Marcolist/EspMoveLamp/hardware/stl/esp32_pcb_carrier.stl

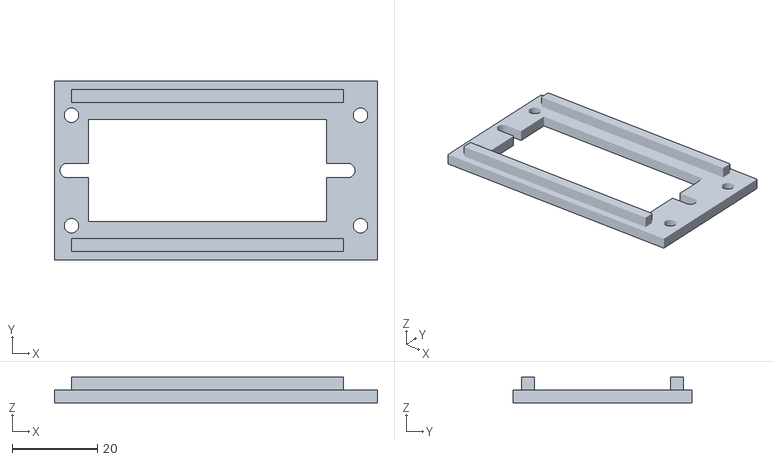
[picture p5: CAD file, 2026-10-15]
hardware/stl/esp32_pcb_carrier.stl
76.0 x 42.0 x 6.00
