Marcolist/EspMoveLamp/hardware/stl/left_electronics_cover.stl

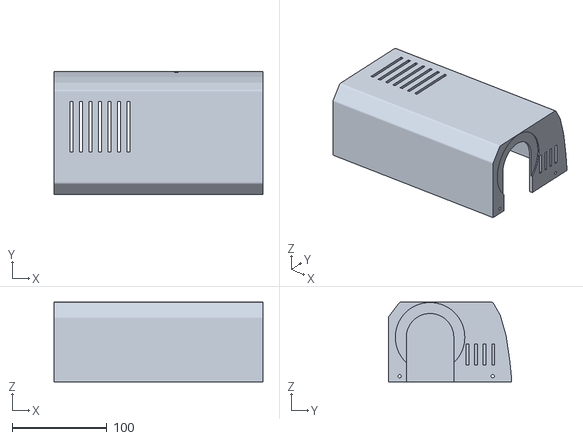
[picture p6: CAD file, 2026-10-15]
hardware/stl/left_electronics_cover.stl
220.0 x 130.0 x 84.0
