Marcolist/EspMoveLamp/hardware/stl/right_cover.stl

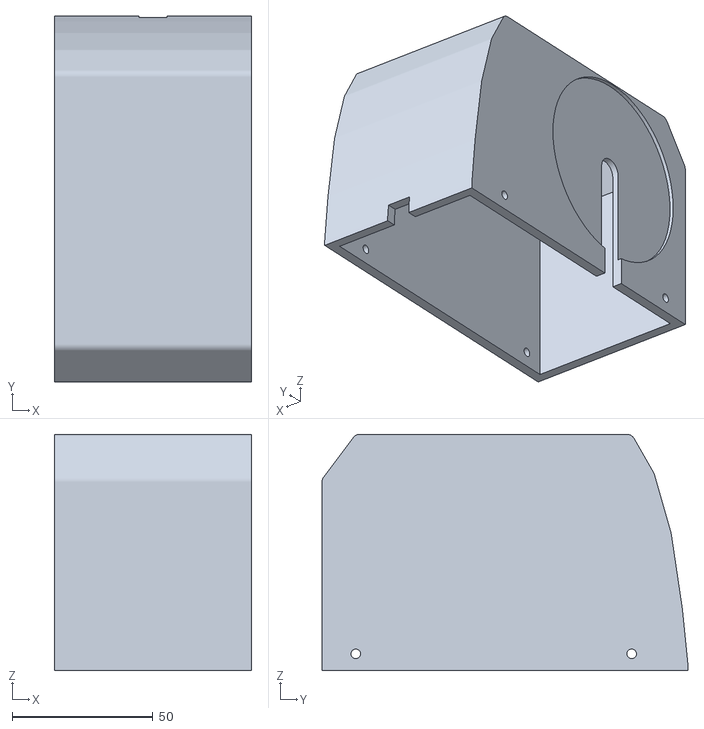
[picture p7: CAD file, 2026-10-15]
hardware/stl/right_cover.stl
70.0 x 130.0 x 84.0
