Marcolist/EspMoveLamp/hardware/stl/psu_terminal_cover.stl

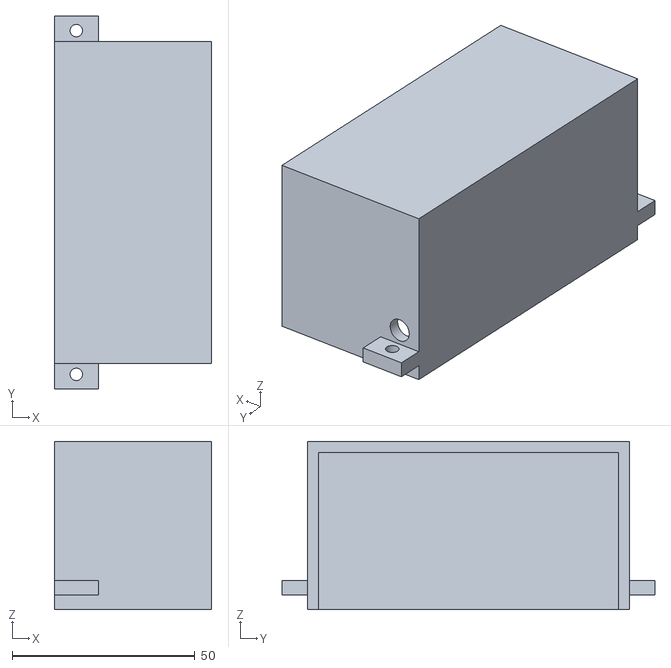
[picture p8: CAD file, 2026-10-15]
hardware/stl/psu_terminal_cover.stl
43.0 x 102.0 x 46.0
