Marcolist/EspMoveLamp/hardware/stl/left_electronics_base.stl

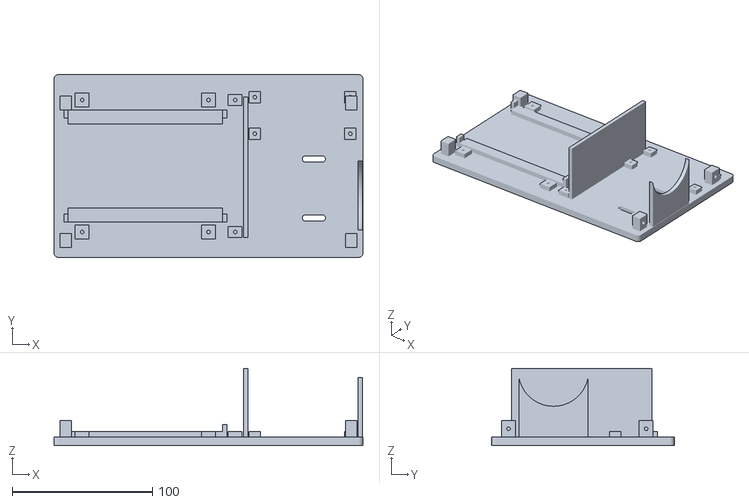
[picture p9: CAD file, 2026-10-15]
hardware/stl/left_electronics_base.stl
220.0 x 130.0 x 55.0
