Marcolist/EspMoveLamp/hardware/stl/right_axle_base.stl

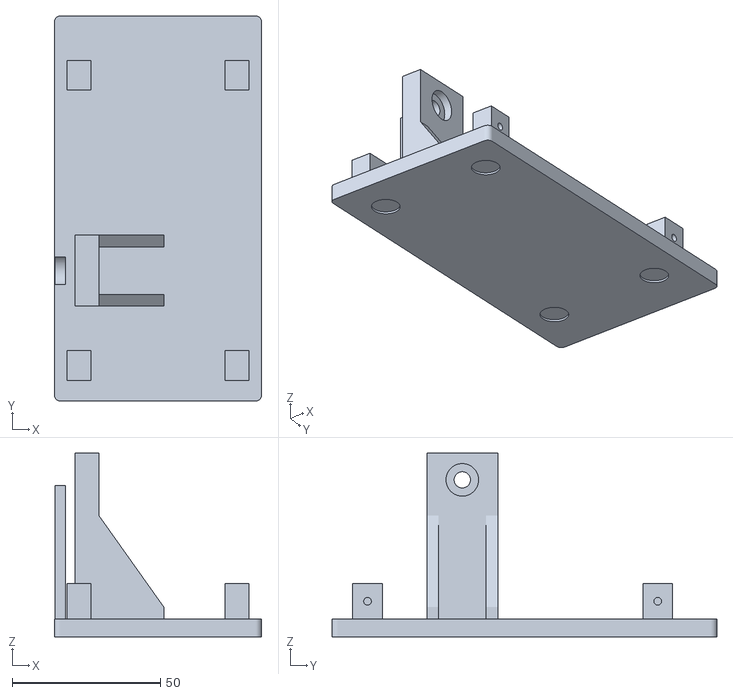
[picture p10: CAD file, 2026-10-15]
hardware/stl/right_axle_base.stl
70.0 x 130.0 x 62.0
