Marcolist/EspMoveLamp/hardware/stl/psu_retaining_bracket_2x.stl

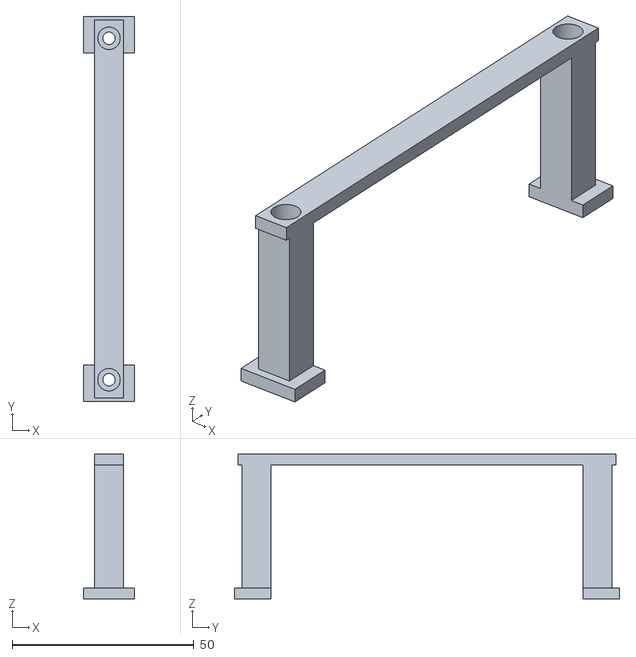
[picture p11: CAD file, 2026-10-15]
hardware/stl/psu_retaining_bracket_2x.stl
14.0 x 106.0 x 39.8
