Marcolist/EspMoveLamp/hardware/stl/profile_front_coupling_disc_2x.stl

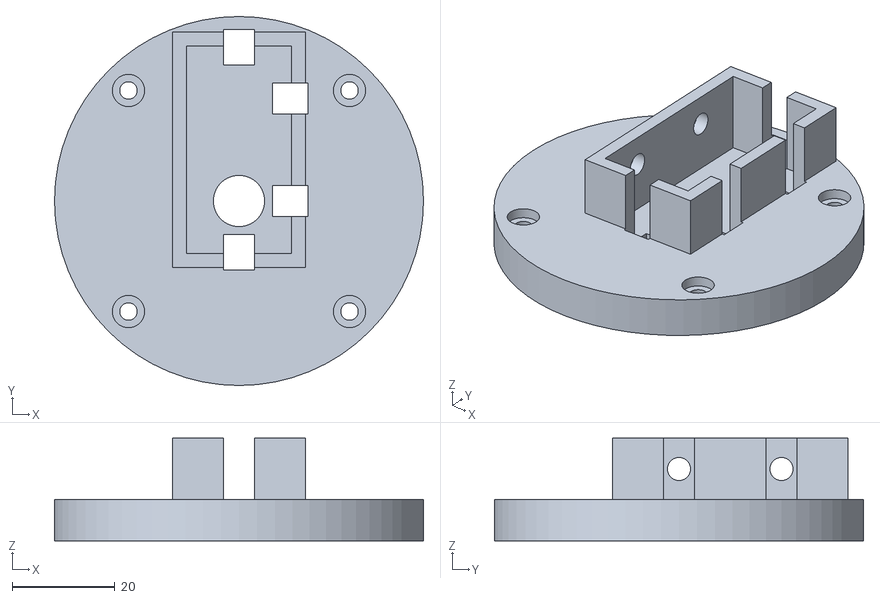
[picture p12: CAD file, 2026-10-15]
hardware/stl/profile_front_coupling_disc_2x.stl
72.0 x 72.0 x 20.0
