Marcolist/EspMoveLamp/hardware/stl/esp32_pcb_retainer_2x.stl

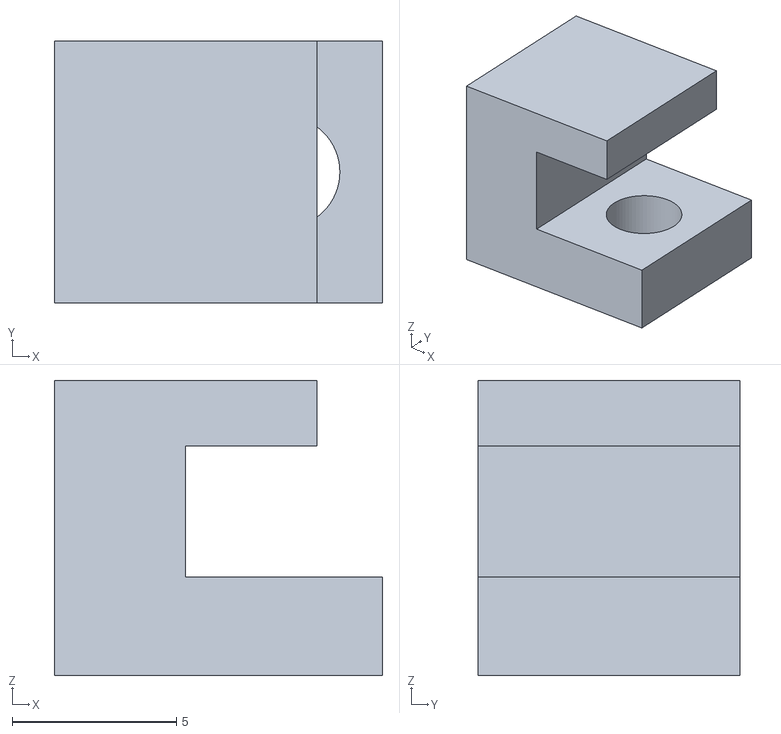
[picture p13: CAD file, 2026-10-15]
hardware/stl/esp32_pcb_retainer_2x.stl
10.0 x 8.00 x 9.00
