Marcolist/EspMoveLamp/hardware/stl/axle_rear_coupling_disc.stl

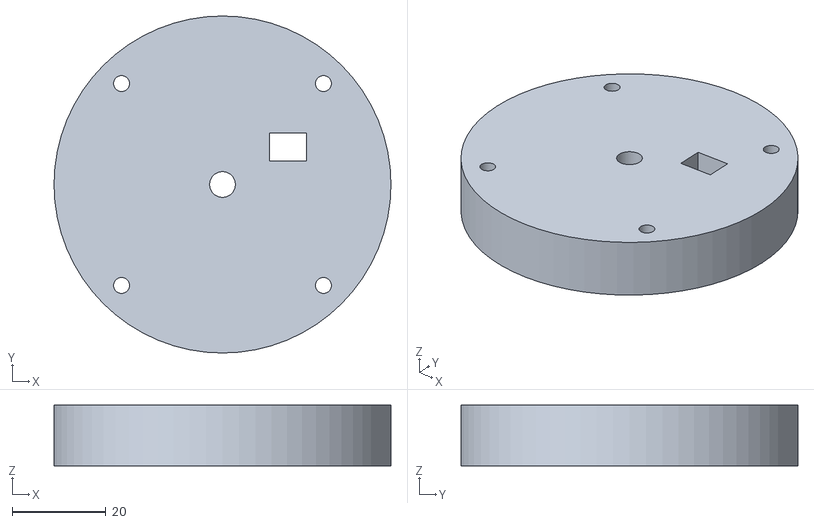
[picture p14: CAD file, 2026-10-15]
hardware/stl/axle_rear_coupling_disc.stl
72.0 x 72.0 x 13.0
