Marcolist/EspMoveLamp/hardware/stl/left_ds3225_servo_mount.stl

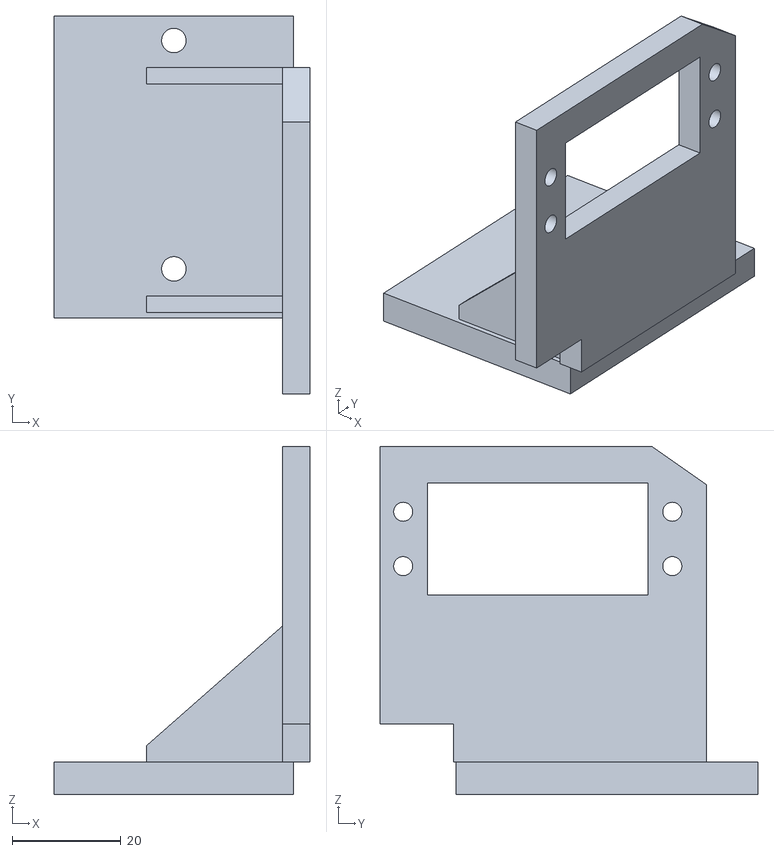
[picture p15: CAD file, 2026-10-15]
hardware/stl/left_ds3225_servo_mount.stl
47.0 x 69.5 x 64.0
