Marcolist/EspMoveLamp/hardware/cad/EspMoveLamp.scad

// EspMoveLamp mechanical prototype v0.9 / DS3225 / mm
part="left_base";
$fn=64;
W=70; D=130; H=90; wall=4; // Shared side profile; only widths differ.
axis_y=44; axis_z=53;
// DS3225 datasheet: body40x20, flange49.5x10, flange length54.5.
servo_body_l=40.6; servo_body_w=20.6;
servo_plate_x=10; // adjustable bracket via base slots
servo_plate_thick=5;
// Horn outer screw radius24 documented; outline clearances remain fit test.
horn_r=24; horn_total=35.8; horn_width=15.8; horn_thickness=6.3;
profile_w=20.5; profile_h=40.5;
cap_d=72; cap_bolt_r=30.5;
cable_slot_width=6; // provisional until actual extrusion slot measured
// Common concealed outlet, away from negative-u servo arm.
module wireport(h=40){translate([10,5,-1])cube([8,6,h]);}
module nutports(){
 // Actual four LED faces: two at +u, one at +v, one at -v.
 for(v=[0,20])translate([6.5,v-cable_slot_width/2,-1])cube([7,cable_slot_width,25]);
 for(v=[-10,30])translate([-cable_slot_width/2,v-3.5,-1])cube([cable_slot_width,7,25]);
}
module wirepath(points){for(i=[0:len(points)-2])hull(){
 for(j=[i,i+1])translate([points[j][0],points[j][1],-0.1])cylinder(d=cable_slot_width,h=3.1);
}}
module wirechannels(){
 wirepath([[10,0],[14,8]]);
 wirepath([[10,20],[14,8]]);
 wirepath([[0,30],[14,24],[14,8]]);
 wirepath([[0,-10],[14,-10],[14,8]]);
}
module profile(){
 // Same full-size side contour for both stands; no scaling of axle features.
 offset(r=3)offset(delta=-3)
 polygon([[0,0],[D,0],[D,8],[D-2,28],[D-6,55],
          [D-12,76],[D-20,H],[12,H],[0,74]]);
}

module extrude_x(l){rotate([90,0,90])linear_extrude(l)children();}
module xhole(x,y,z,d,l){translate([x,y,z])rotate([0,90,0])cylinder(d=d,h=l);}
module zhole(x,y,z,d,l){translate([x,y,z])cylinder(d=d,h=l);}
module zslot(x1,x2,y,z,d,h){hull(){zhole(x1,y,z,d,h);zhole(x2,y,z,d,h);}}
module base(right=true){difference(){union(){
 linear_extrude(6)offset(r=2)offset(delta=-2)square([W,D]);
 // Hood attachment lugs, accessible horizontally from outside.
 for(x=[8.3,61.7],y=[12,110])translate([x-4,y-5,6])cube([8,10,12]);
 if(!right){
 // Simple integral axle pedestal, completely exposed without hood.
 translate([7,32,6])cube([8,24,56]);
 for(y=[32,52])hull(){translate([7,y,6])cube([30,4,4]);translate([7,y,6])cube([8,4,35]);}
 }
 }
 for(y=[12,110]){xhole(-1,y,12,2.6,13);xhole(58,y,12,2.6,13);}
 if(right){
 // M4 through slots allow the bracket to move 12mm along servo axis.
 for(y=[28,70])zslot(29,41,y,-1,4.5,8);
 }else{xhole(6,axis_y,axis_z,5.5,11);xhole(12,axis_y,axis_z,11,5);}
 // Anti-slip pad pockets on underside.
 for(x=[13,57],y=[15,110])zhole(x,y,-0.1,10,0.9);
}}
module servo_bracket(){difference(){union(){
 // Part in assembly coordinates, foot underside z6.
 translate([13,19,6])cube([44,55.5,6]);
 translate([servo_plate_x,0,0])extrude_x(servo_plate_thick)
 polygon([[5,12],[65,12],[65,63],[55,70],[5,70]]);
 // Buttress ribs stay below servo body and mounting ears.
 for(y=[20,62])hull(){translate([servo_plate_x,y,12])cube([30,3,3]);translate([servo_plate_x,y,12])cube([5,3,25]);}
 }
 // Clearance above forward hood attachment lug.
 translate([-1,0,5])cube([72,18.5,14]);
 translate([servo_plate_x-1,34-servo_body_l/2,53-servo_body_w/2])cube([7,servo_body_l,servo_body_w]);
 for(y=[34-49.5/2,34+49.5/2],z=[48,58])xhole(servo_plate_x-1,y,z,3.5,8);
 for(y=[28,70])zhole(35,y,5,4.5,9);
}}
module hood(right=true){difference(){
 extrude_x(70)profile();
 // Hollow right through lower edge, no hidden bottom membrane.
 translate([4,0,0])extrude_x(62)offset(delta=-4)profile();
 translate([-1,-1,-1])cube([W+2,D+2,7]);
 // U opening permits lifting hood off the installed spindle.
 hull(){xhole(-1,axis_y,axis_z,right?50:10,7);xhole(-1,axis_y,0,right?50:10,7);}
 // Radial cosmetic relief, not a bearing surface.
 xhole(-0.1,axis_y,axis_z,73.2,1.6);
 for(y=[12,110]){xhole(-1,y,12,3.4,6);xhole(65,y,12,3.4,6);}
 // Cable exit aligned with rear lower edge, connector accessible.
 translate([30,D-6,5])cube([10,8,8]);
}}
module capbolts(){for(a=[45,135,225,315])translate([cap_bolt_r*cos(a),cap_bolt_r*sin(a),-1])cylinder(d=3.4,h=18);}
module rear_servo(){difference(){
 cylinder(d=cap_d,h=13);
 // Pocket OPENS TO SERVO at z0. Original metal horn engages spline there.
 translate([-27.9,-horn_width/2,-0.1])cube([horn_total,horn_width,6.4]);
 // Hub + retaining-screw access. Diameter must be fit-checked on actual horn.
 zhole(0,0,-1,18,16);
 // Fixed outer horn hole at documented radius24; accessible from profile side.
 zhole(-horn_r,0,-1,3.4,16);
 capbolts();wireport();
 for(a=[45,135,225,315])translate([cap_bolt_r*cos(a),cap_bolt_r*sin(a),-0.1])cylinder(d=6.6,h=2.6,$fn=6);
}}
module rear_axle(){difference(){cylinder(d=cap_d,h=13);zhole(0,0,-1,5.5,16);capbolts();wireport();for(a=[45,135,225,315])translate([cap_bolt_r*cos(a),cap_bolt_r*sin(a),-0.1])cylinder(d=6.6,h=2.6,$fn=6);}}
module cap_front(){difference(){union(){
 // 4mm end-stop keeps actual extrusion out of wire-routing plenum.
 cylinder(d=cap_d,h=8);
 translate([0,10,8])linear_extrude(12)difference(){square([26,46],center=true);square([profile_w,profile_h],center=true);}
 }
 translate([0,10,4])linear_extrude(20)square([profile_w,profile_h],center=true);
 // Main bolt pattern must pass through full8mm plate.
 for(a=[45,135,225,315])translate([cap_bolt_r*cos(a),cap_bolt_r*sin(a),-1])cylinder(d=3.4,h=12);
 // Blind underside pocket clears installed M3 screw head; outside stays closed.
 zhole(-horn_r,0,-0.1,9,3.6);
 // Horn fastener is mounted BEFORE closing the two cap halves.
 zhole(0,0,-1,10,11);
 nutports();wirechannels(); // blind channels: no extra outward square outlet
 for(a=[45,135,225,315])translate([cap_bolt_r*cos(a),cap_bolt_r*sin(a),6])cylinder(d=6.3,h=3);
 for(v=[0,20])translate([-15,v,14])rotate([0,90,0])cylinder(d=4.5,h=6);
}}
// Electronics housing: local x=0 faces light bar; export mirrored for LEFT.
LW=220; LD=D; LH=H;
psu=[110,80,36]; psu_pos=[100,25,10];
// Relocate PSU fixtures; carrier mounting margin is adapted to the shell wall.
psu_shift=[80,-50,0]; board_shift=[-71,64,0];
board_max=[64,34]; // Exact PCB size must be checked on the actual board.
module large_profile(){profile();}
module placed_carrier(){translate(board_shift)esp_carrier();}
module placed_shroud(){translate(psu_shift)terminal_shroud();}
module placed_straps(){translate(psu_shift)for(x=[30,120])translate([x,0,0])psu_strap();}
module lip_fill(){
 // Fills U opening below the round50mm cable/spindle opening.
 difference(){translate([0.3,axis_y-24.6,6])cube([3.4,49.2,47]);
 xhole(-1,axis_y,axis_z,50,7);}
}
module electronics_base(){difference(){union(){
 linear_extrude(6)offset(r=3)offset(delta=-3)square([LW,LD]);
 lip_fill();
 // Hood supports. Rear posts sit before low tail of shell.
 for(x=[8.3,LW-8.3],y=[12,110])translate([x-4,y-5,6])cube([8,10,12]);
 // PSU now sits beside the servo, along the housing width.
 translate(psu_shift){
  for(y=[75,145])translate([20,y,6])cube([110,10,4]);
  for(x=[17,130],y=[75,149])translate([x,y,6])cube([3,6,9]);
  for(x=[30,120],y=[68,162])translate([x-5,y-5,6])cube([10,10,4]);
  for(y=[68,162])translate([6,y-4,6])cube([10,8,4]);
 }
 // Low-voltage partition beside the protected PSU terminal area.
 translate([82,14,6])cube([3,100,49]);
 translate(board_shift)for(x=[80,148],y=[24,50])translate([x-4,y-4,6])cube([8,8,4]);
 }
 // Existing servo mount, same axle height and offset as compact right side.
 for(y=[28,70])zslot(29,41,y,-1,4.5,8);
 for(y=[12,110]){xhole(-1,y,12,2.6,13);xhole(LW-12,y,12,2.6,13);}
 translate(psu_shift)for(x=[30,120],y=[68,162])zhole(x,y,5,2.6,7);
 translate(board_shift)for(x=[80,148],y=[24,50])zhole(x,y,5,2.6,7);
 translate(psu_shift)for(y=[68,162])zhole(11,y,5,2.6,7);
 for(x=[14,LW-14],y=[15,LD-19])zhole(x,y,-0.1,12,0.9);
}}
module electronics_hood(){difference(){
 extrude_x(LW)large_profile();
 translate([4,0,0])extrude_x(LW-8)offset(delta=-4)large_profile();
 translate([-1,-1,-1])cube([LW+2,LD+2,7]);
 hull(){xhole(-1,axis_y,axis_z,50,7);xhole(-1,axis_y,0,50,7);}
 xhole(-0.1,axis_y,axis_z,73.2,1.6);
 for(y=[12,110]){xhole(-1,y,12,3.4,6);xhole(LW-5,y,12,3.4,6);}
 // Low-voltage-zone wall vents. Terminal area remains unperforated.
 for(y=[82:9:109])translate([-1,y,24])cube([7,3,22]);
 // Rear exhaust above protected metal PSU housing, not above front terminals.
 for(x=[140:10:200])translate([x,45,53])cube([3,53,50]);
 // Cable-entry pilot at rear in terminal-shroud area.
 // Real strain-relief fitting determines finished diameter; not final mains entry.
 translate([91,LD-5,18])rotate([-90,0,0])cylinder(d=6,h=7);
}}
module psu_strap(){difference(){union(){
 // One strap spans y63..167; two are installed at x30 and120.
 translate([-4,63,46.8])cube([8,104,3]);
 for(y=[64,158])translate([-4,y,10])cube([8,8,39.8]);
 for(y=[62,158])translate([-7,y,10])cube([14,10,3]);
 }
 for(y=[68,162]){zhole(0,y,9,3.4,45);zhole(0,y,46,6.2,5);}
}}
module esp_carrier(){difference(){union(){
 // No fixed DevKit drilling pattern: supports edges of a provisional64x34 PCB.
 translate([76,16,10])cube([76,42,3]);
 for(y=[18,53])translate([80,y,13])cube([64,3,3]);
 }
 // Open underside area avoids covering all board solder joints.
 translate([84,25,9])cube([56,24,5]);
 for(x=[80,148],y=[24,50])zhole(x,y,9,3.4,6);
 // Slots for two small printable retaining fingers at PCB ends.
 for(x=[82,142])zslot(x-3,x+3,37,9,3.4,7);
}}
module esp_finger(){difference(){union(){cube([10,8,3]);translate([0,0,3])cube([4,8,4]);translate([0,0,7])cube([8,8,2]);}zhole(7,4,-1,3.4,5);}}
module terminal_shroud(){difference(){union(){
 // Secondary terminal barrier; open rear fits over metal PSU edge.
 translate([5,71,6])cube([43,88,46]);
 for(y=[68,162])translate([5,y-4,10])cube([12,8,4]);
 }
 translate([8,74,5])cube([42,82,44]);
 for(y=[68,162])zhole(11,y,9,3.4,7);
 translate([11,154,18])rotate([-90,0,0])cylinder(d=6,h=10);
 // Pilot only: actual rated cable fitting determines final opening.
}}
module left_flip(){mirror([1,0,0])translate([-LW,0,0])children();}
if(part=="left_base")left_flip()electronics_base();
if(part=="left_hood")left_flip()electronics_hood();
if(part=="servo_mount")left_flip()translate([0,0,-6])servo_bracket();
if(part=="right_base"){base(false);small_axle_fill();}
if(part=="right_hood")hood(false);
if(part=="horn_cap")rear_servo();
if(part=="axle_cap")rear_axle();
if(part=="profile_cap")cap_front();
if(part=="psu_strap")translate([0,-62,-10])psu_strap();
if(part=="esp_carrier")translate([-76,-16,-10])esp_carrier();
if(part=="esp_finger")esp_finger();
if(part=="terminal_shroud")translate([-5,-64,-6])terminal_shroud();
// Non-printable reference parts / inspection, only for collision and layout.
module psu_reference(){translate(psu_pos)cube(psu);}
module esp_reference(){translate(board_shift)translate([80,20,16])cube([64,34,12]);}
module servo_reference(){translate([15,14,43])cube([27.7,40,20]);}
module installed_parts(){
 electronics_base();servo_bracket();placed_carrier();placed_shroud();placed_straps();
}
if(part=="inspection")left_flip(){installed_parts();psu_reference();esp_reference();servo_reference();}
if(part=="collision_hood_parts")intersection(){electronics_hood();installed_parts();}
if(part=="collision_hood_psu")intersection(){electronics_hood();psu_reference();}
if(part=="collision_hood_esp")intersection(){electronics_hood();esp_reference();}
if(part=="collision_shroud_psu")intersection(){placed_shroud();psu_reference();}
module small_axle_fill(){difference(){translate([0.3,axis_y-4.6,6])cube([3.4,9.2,47]);xhole(-1,axis_y,axis_z,10,7);}}

if(part=="collision_right_hood_base")intersection(){hood(false);union(){base(false);small_axle_fill();}}
if(part=="collision_parts_psu")intersection(){psu_reference();union(){servo_bracket();placed_carrier();}}
if(part=="collision_shroud_carrier")intersection(){placed_shroud();placed_carrier();}
if(part=="collision_carrier_servo")intersection(){placed_carrier();servo_bracket();}

if(part=="collision_hood_base")intersection(){electronics_hood();electronics_base();}
if(part=="collision_hood_servo")intersection(){electronics_hood();servo_bracket();}
if(part=="collision_hood_carrier")intersection(){electronics_hood();placed_carrier();}
if(part=="collision_hood_shroud")intersection(){electronics_hood();placed_shroud();}
if(part=="collision_hood_straps")intersection(){electronics_hood();placed_straps();}
