Marcolist/EspMoveLamp/(list of files, cad)

Other CAD files:
hardware/stl/servo_rear_coupling_disc.stl
