Marcolist/EspMoveLamp/(commit log)

2026-10-15 Document direct ESP32 to LED wiring
2026-10-15 Compact housings with matching side profiles and internal PSU layout
    [EspMoveLamp.scad, esp32_pcb_carrier.stl, left_electronics_base.stl, left_electronics_cover.stl, psu_terminal_cover.stl, right_axle_base.stl, right_cover.stl]
2026-10-24 Use one GPIO data output for each LED strip
